Kalidomra/AdamNet-Drive-Emulator/Connection Diagram.jpg

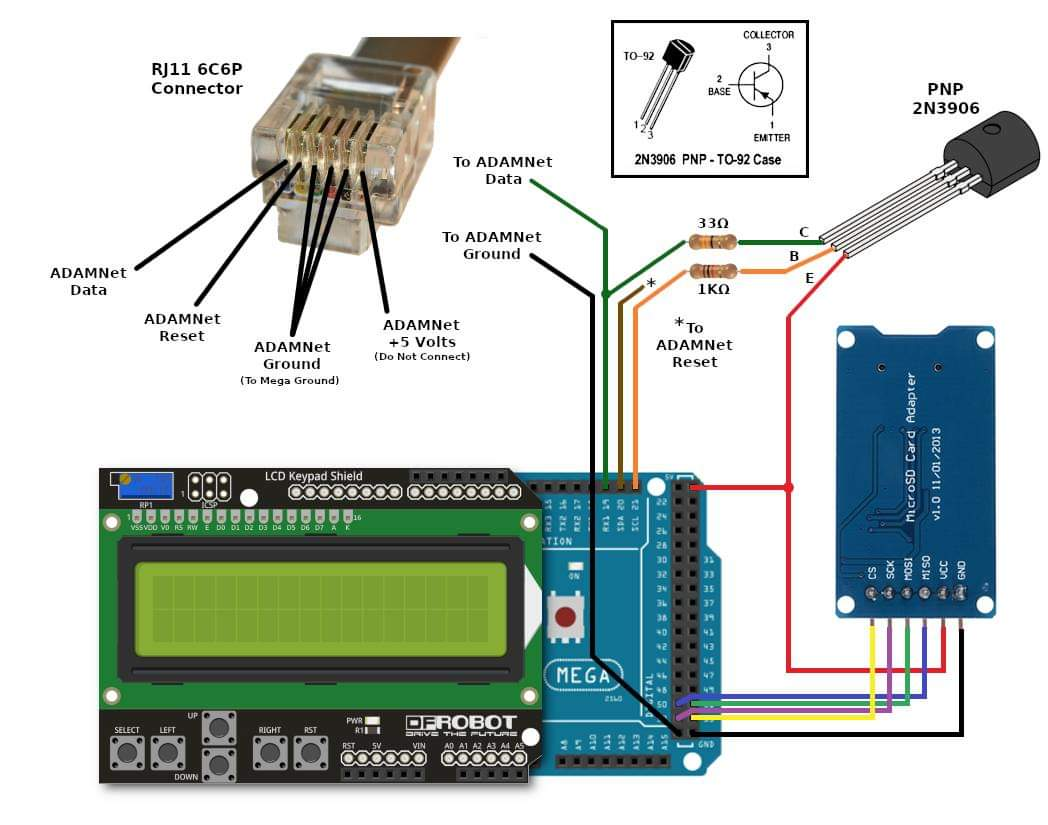
Connection Diagram.jpg
