Kalidomra/AdamNet-Drive-Emulator/(threads)

Thread 1 (2019-01-05):

Remember last file loaded apon reset or power on

JohnLundy, 2019-01-05:
The ability to remember last file loaded and have it default back to it after reset/power on to know where you left off the last time would be nice. Same functionality as the VDD. They save a text file on the SD card with the last loaded file.

Kalidomra, 2019-01-07:
Done.

Closed 2019-01-07.

Thread 2 (2019-01-05):

Make mount key dual purpose to mount and unmount files

JohnLundy, 2019-01-05:
The ability to use the mount key also as the unmount key will reduce keys required and simplify things. Same functionality as the VDD.

Kalidomra, 2019-01-05:
Can you clarify how this works? Right now if you select the mount key, it unmounts and then mounts the currently selected file on the bottom line.

You want to push the key twice to select a new file? Once to unmount and again to mount?

JohnLundy, 2019-01-05:
Correct, push twice to select a new file. This gives the option of having nothing mounted without using the left button. Everyone is familiar with this method from using the VDD. If this ever becomes a product or custom shield made, it will require less parts or possibly free up a button for future options.

Kalidomra, 2019-01-07:
Done.

Closed 2019-01-07.

Thread 3 (2019-01-07):

R/W activity LED

JohnLundy, 2019-01-07:
Would it be nice to have an activity LED flash when drives are reading or writing. Large loads keep you wondering if anything is happening.

Kalidomra, 2019-01-07:
Should be there. The default is the LED on the Mega, that happens to get covered up by the keypad. You can easily add an external LED with a resistor. Default is Pin 13.

JohnLundy, 2019-01-07:
Yep, I didn't notice it under the LCD/Button shield. I added an LED to the shield to make it viewable.

Closed 2019-01-07.

Thread 4 (2019-01-07):

Bug that allows same file to be mounted to multiple drives

JohnLundy, 2019-01-07:
Bug that allows same file to be mounted to multiple drives

Kalidomra, 2019-01-07:
This is not a bug. It is part of the current implementation. Because of the serial nature of AdamNet the same file can be accessed by multiple drives. Each time a block of 1k data to written, the file is opened and closed.

JohnLundy, 2019-01-07:
Gotcha, thanks for clearing that up. It's kind of hard to wrap your head around it at first.

Closed 2019-01-07.

Thread 6 (2019-01-07):

Read error during boot of ADAMCalc

JohnLundy, 2019-01-07:
Read error during boot of ADAMCalc. Was not an issue with first beta. Reloaded original beta and confirmed it does load fine on two separate ADAM consoles. Something changed?

JohnLundy, 2019-01-07:
I have now verified the same behavior with all three of my complete ADAM setups.

Kalidomra, 2019-01-08:
I have isolated the problem. It will take a re-write of the handling of the SD card file names. This is required to free up some additional memory. I was using a shared buffer for all 4 drives. This doesn't work with some programs as they expect repeat block reads to be immediate. So, I will need 4 x 1k buffers. One for each drive. The additional benefit will be an increase in the number of files and the length of the file names that can be used.

It will take a few days to re-write the SD card file name display section and setup the additional buffers.

Kalidomra, 2019-01-09:
My latest builds load Buck Rogers fine and plays through a few levels. Unfortunately, I'm not very good at it. I did not change the main read routine very much. Can you send me the image you tried, so I can check it.

JohnLundy, 2019-01-09:
Buck Rogers problem solved. Over the last couple days I switched from mirco SD to SD and used an older card with game images and apparently Buck Rogers was corrupt. Sorry for the confusion.

Kalidomra, 2019-01-11:
Fixed in v0.3

Closed 2019-01-11.

Thread 10 (2019-01-16):

Add the ability to auto mount a file to Drive 1.

Kalidomra, 2019-01-16:
This would automatically mount the designated file on an ADE reset. It would ignore any previously mounted files if the mount file was present. The file name will default to boot.dsk, but can be changed in the configuration section.

Kalidomra, 2019-02-08:
Complete in v0.4

Closed 2019-02-08.

Thread 11 (2019-01-16):

Add ability for individual input switches instead of analog line

JohnLundy, 2019-01-16:
Add the option in code to not use the analog switch input AD0 line and use dedicated digital I/O lines (selectable lines in code like for the activity indicator lines) for individual switches instead? This would come in handy for people who want to make custom projects and avoid dealing with possible resistor tolerance issues with using analog. Each line pulled low and detected with logical high with switch closure.

Kalidomra, 2019-01-16:
How many buttons are you thinking?

JohnLundy, 2019-01-16:
That's even better. The ADE is designed to work with the five switches on the LCD/Button shield. I'd say the ability for all five makes the most sense, even though I don't use the dedicated unmount switch in favor of the mount/unmount dual purpose switch.

Kalidomra, 2019-01-16:
Do you know how the ADE reacts if there is nothing attached to the AD0? Do I have to disable it in code or can I leave both analog and digital buttons functional regardless of whether they are installed or not.

JohnLundy, 2019-01-16:
I don't know the exact answer to that without real world testing. With that said, the AD0 line requires a 2k pull up for normal operation as part of the switch voltage divider even without any switch closures according to the schematic. I see no reason the system couldn't have both input methods, I just wouldn't leave the AD0 line floating without a 2k pull up to play it safe.

Kalidomra, 2019-01-16:
I will add the ability to disable the analog buttons in the configuration section.

Kalidomra, 2019-02-08:
Complete in v0.4

Closed 2019-02-08.

Thread 7 (2019-01-16):

Add support for Control Commands from the Adam.

Kalidomra, 2019-01-16:
Use the high byte of the high word on the block wanted to control the ADE from the Adam. Current list of proposed commands:
**F1 - Return Current SD Card Directory:** This would include an index number and the filename. There should be a limit on the filename length as 255 bytes would not be reasonable on the Adam. I propose to use 60. That would mean we could have 16 directory entries sent back per block read. So the Adam program would need to read multiple blocks to retrieve the whole directory. Read blocks F1000001, F1000002, F1000003, etc. It would not matter which device the read is issued to.
**F2 - Return Currently Mounted Disk:** If you read the block F2000000 on device 4, it would return the currently mounted file name in the block read.
**F3 - Mount/Unmount Disk:** This would mount the disk by index number. Using the lower word as the index to mount. So if you read F3000112 on device 4, the ADE would mount file 274 (112 hex) on device 4.  Sending a 0 index number would unmount.
**F4 - Write to LCD:** This is a write command. Load the block with 32 bytes of ascii text and send this as a write. The ADE will then display the text on the LCD. It would not matter which device the write is issued to.
**FA - Format:** This would format the device. This would be an alternative to the existing FACE. This is required so we can disable the original FACE support and use that block without a risk of format.

Kalidomra, 2019-02-08:
Complete in v0.4. See the included sample ADE basic disks to see how it works.

Closed 2019-02-08.

Thread 12 (2019-01-17):

Add the ability to reset the Adam on ADE reset

Kalidomra, 2019-01-17:
This would reset the Adam when the ADE finishes all of the setup.  It would require that the reset line from the AdamNet connect be attached to a pin on the Arduino. The benefit to this would be that if a boot disk is defined, one button press would re-mount the boot disk and reset the Adam. A variable in the configuration section should allow this to be disabled.

Kalidomra, 2019-01-21:
This does not appear to be possible. The reset line on the Adamnet is an output not an input . So it will signal a reset of the Adam, but we can not initiate a reset.

Closed 2019-01-21.

Thread 13 (2019-02-13):

Add Device Selection Menu

Kalidomra, 2019-02-13:
If the Drive Select button is held on power up, jump to a drive selection menu. This would allow the user to select the drives to be turned on or off.

Kalidomra, 2019-02-28:
Complete in v0.5.

Closed 2019-02-28.

Thread 14 (2019-03-17):

Analog buttons still enabled during boot when using digital buttons

JohnLundy, 2019-03-17:
Analog buttons still enabled during boot when using digital buttons and intermittently causing unit to falsely boot to config mode on power up. This is an issue only when designs are based around using digital buttons.  Need to add check if ‘EnableAnalogButtons = false’ variable is set to ignore analog buttons during boot when checking if the select key is held down to enable config mode on boot up.

Kalidomra, 2019-03-20:
Fixed in beta v0.6

Closed 2019-03-20.

Thread 15 (2019-03-17):

Button scan time changes for digital buttons vs. analog buttons

JohnLundy, 2019-03-17:
Add the ability to change button scan times based on both digital and analog button settings. Maybe have this ability tied to the ‘EnableAnalogButtons = false/true’ variable adjustment.

Analog buttons seem to work best with a setting of ButtonDelay >= 150 and digital buttons seem to work best with a setting of ButtonDelay >= 120.

Kalidomra, 2019-03-20:
Added to beta v0.6

Closed 2019-03-20.

Thread 17 (2019-04-16):

Send the ADE status on a 0xDEADBEEF read

Kalidomra, 2019-04-16:
When switching to the enhanced mode on a read to block 0XDEADBEEF, send the status of the ADE. This could include the firmware version also. This would enable the Adam to detect when an ADE is connected and not another device.

Kalidomra, 2019-05-26:
Added to v0.70.

Closed 2019-05-26.

Thread 18 (2019-04-16):

Boot disk image is case sensitive

JohnLundy, 2019-04-16:
For the boot image to automatically boot it has to be all lowercase in order to work, including the extension. Add the ability to make it not case sensitive to make it less confusing.

Kalidomra, 2019-04-16:
The boot disk filename is definable in the variables at the top of the main Arduino file. In order to make this more user friendly, the defined filename and the filename read from the SD card will need to be converted to lower case and then compared. This should be simple to implement.

Kalidomra, 2019-05-26:
Fixed in v0.70.

Closed 2019-05-26.

Thread 20 (2019-05-14):

Adam Software Initiated Reset

Kalidomra, 2019-05-14:
If the Adam initiates a "soft" reset and there is a boot.dsk on the SD card, the boot.dsk it mounted and causes issues. 3 know titles that this is an issue:
 - Family Feud
 - Jeopardy
 - Bible Jeopardy

These disks start fine and half way through the loading process initial a reset on the Adam.

Kalidomra, 2019-05-26:
Fixed in v0.70.

Closed 2019-05-26.

Thread 21 (2019-05-28):

Setting ‘const unsigned int namelength =’ less than 71 will lock up the ADE.

JohnLundy, 2019-05-28:
Setting ‘const unsigned int namelength =’ to less than 41 locks the ADE up on boot. Setting it between 41 and 71 will lock the ADE when scrolling through files. Higher the setting will require more scrolling to lock up the ADE. This appears to be a carryover from v0.6 as well.

Kalidomra, 2019-09-23:
Fixed in v0.80

Closed 2019-09-23.

Thread 22 (2019-07-30):

When using an IDEboot PROM the boot timing is altered and changes the TimeSinceReset value causing issues with ADE compatibility

JohnLundy, 2019-07-30:
When using an IDEboot PROM in expansion slot 2 the boot timing is altered and changes the TimeSinceReset value causing issues with ADE compatibility. It has been found that it is required to add an additional lower range for compatibility. Tests have show a range of 15 – 23 is required.

 if (((TimeSinceReset <= 175) && (TimeSinceReset >= 153)) || ((TimeSinceReset <= 23) && (TimeSinceReset >= 15))){ // Lower range is needed for IDEboot PROM compatibility

Kalidomra, 2019-09-23:
Fixed in v0.80

Closed 2019-09-23.

Thread 23 (2019-07-30):

SD Command issues mounting D3 and also throwing errors in the terminal with v0.73

JohnLundy, 2019-07-30:
SD Command issues mounting D3 and also throwing errors in the terminal with v0.73. It has been found that the buffer needs to be zeroed out first to correct this issue.

Replace:
LoadedBlock[devicenumber-4] = 0xFFFFFFFF;

With:
BlockBuffer[devicenumber-4][0] = 0xB0 + devicenumber; // Need to zero out the buffer
BlockBuffer[devicenumber-4][1] = 0x04;
BlockBuffer[devicenumber-4][2] = 0x00;

Kalidomra, 2019-09-23:
Fixed in v0.80

Closed 2019-09-23.

Thread 24 (2019-12-09):

Read Errors on some Clone Arduino Megas

Kalidomra, 2019-12-09:
Some cheaper Arduino clones use poor quality resonators. This can cause read errors on AdamNet, due to the bit bang timing being off. The Motorola 6801 that is used in the Adam is able to tolerate up to 3.5% difference in serial communication speed.

plasticuser, 2020-02-11:
I should be ok with a +/- 2--ppm oscillator on my custom Pro board?

Kalidomra, 2020-02-11:
Generally an oscillator is the preferred method. They are very accurate. 2 ppm is equal to 15999968 hz - 16000032 hz. The issue is with the low quality resonators that some mega clones use. These appear to be outside of the normal tolerances of a name brand resonator. I have measured some at 15850700 hz.

plasticuser, 2020-02-11:
2--ppm should be 200ppm, sorry.

I'm developing a single board ADE interface that could support two SD cards, ADAMNet pass-thru, and if you'll support it a more satisfying OLED or mini-TFT display. I'm also going to make it VERY small. My main objective is to lower the price so it is more accessible.

I would love to pick your brains about some smaller technical matters, eg: power, and the notion of forking your ADAMNet stack for a video adapter I've designed. dave@nonstickglue.com

Kalidomra, 2020-02-11:
200ppm is more than accurate enough. I have modified the timings to tolerate the worst mega clone that I have. I am currently testing this. It will be released soon.

If you want to add a feature to the ADE, submit an issue as an improvement. Or you can create your own fork.

plasticuser, 2020-02-11:
I'd prefer to keep everything unified - forks muddy the waters too much. People need a consistent experience. I'll post a couple of thoughts...

Kalidomra, 2020-02-23:
Fixed in v0.82

Closed 2020-02-23.

Thread 25 (2020-02-04):

Some users are experiencing bounce issues with buttons

JohnLundy, 2020-02-04:
Some users are experiencing bounce issues with buttons causing issues. This is especially noticeable when scrolling through the image file list and is causing images to be skipped and not displayed.

Kalidomra, 2020-02-23:
Fixed in v0.82

Closed 2020-02-23.

Thread 26 (2020-02-11):

Request OLED or TFT display support...

plasticuser, 2020-02-11:
It would be nice to move beyond 1602 displays. Besides not being very clear, they crop off a lot of the file names. A modest OLED display based around a common chipset would be easy to support.

The killer feature is being able to have three lines of clear, high resolution text, so you can see the selected file, the file above and the file below as you scroll through the list. I think this would greatly improve usability.

Kalidomra, 2020-02-11:
Please specify the OLED you are thinking of using.

plasticuser, 2020-02-11:
I was thinking an I2C 0.96" 128x64 unit using the SSD1306 driver. This doesn't interfere with your current use of SPI. They are available in white, blue, or yellow top 1/4 and blue bottom 3/4, There are many brands to choose from. SSD1306 also supports a range of color TFT displays, and other OLED displays of 128x32 size, though those are a bit small for this.

plasticuser, 2020-03-01:
I have developed this idea further, and this feature has become quite essential to my plans. I intend to add a remote control with a custom matrix keypad - mostly because having a custom remote matrix made and using an OLED display is a cheaper and more elegant solution than buying expensive 1602 displays on button entry PCBs.

Anything which only uses an IR link will work natively with your code without changes, introduce mechanical reliability, and increase mounting options to include internal mounting with only the SD slot and a sensor showing.

It will allow me to lower the retail cost of the ADE by another $10-15, while improving mounting options and usability in almost every way. It will also allow people to buy standard arduino accessory parts that are still cheaper than the 1602 input shields. It doesn't limit accessibility at all.

Kalidomra, 2020-03-02:
What about the ADE in it's current form is not "mechanically reliable"?
Why would having the ADE functional with a remote control be desired? Will the keyboard and joysticks also be remote? What about the need to reset the Adam?

plasticuser, 2020-03-03:
Stacks of boards are for prototyping. It's nice that they're available. But to compensate for the fact they're multiple boards held together with jumper wire and push fit contacts, people are charging almost $100 for a box to put it in. One of your stated goals was to make it affordable and accessible to everyone. So, I was simple "productizing" your ADE board. Every request has been an effort to improve the product this code runs on. I do have the ability to produce a single board that can do everything this does for about the same cost as buying all the parts separately - as many have done.

I'm not knocking their experience - I am only reacting to my own observations of my and others' use.

The remote functionality is to allow the ADE to be embedded behind a grille or in a slot. It would allow more room for a larger OLED from the same driver family. The remote would have a custom made front laminate, and would match the Adam perfectly. It would do debounce for you in the remote.

I can't see any benefit in the keyboard or joysticks being remote. The keyboard's an ADAMnet device, and just plugs in right there.

At the end of the day, the LCD/input shield is the weakest and most mechanically vulnerable part of the ADE. It forces a certain chunkiness on the design, and makes it less convenient to embed. It's also the most expensive component. OLED displays are 1/4-1/5 the price. Keyes remotes are 1/4 the price. It just gives people more options to build different implementations. With the SD shield firmly mounted in the 'duino I pressed buttons and the vibration was causing intermittent connection to the SD card, which was problematic.

I'm looking at forking the code, _not to duplicate your work/ADE_ but to use the ADAMnet stack you've developed to allow other options like ADAMnet<>PS/2 adapter as keyboards are in short supply, and an ADAMnet floppy controller, because why not? :D

Closed 2023-03-09.

Thread 27 (2020-02-11):

Keyboard image search

plasticuser, 2020-02-11:
Would it be possible (since the ADAMNet allows every device to snoop every other) that is the keyboard typed an unlikely Hayes-like command (eg: +++ after a three second gap) further typing could be read by the ADE to filter the disk image list down to one or very few images?

Kalidomra, 2020-02-11:
Intercepting the keyboard commands on ADAMNet is possible. However, the Adam will still register the keystrokes.
The way the ADE displays the filename on the display is by looking it up on the SD card. It does not keep a list of the current directory filenames, only index numbers. There is not enough memory left on the mega to have a large text array. In order to complete this type of alphabetical sort, it would need to look up each file in the current directory on the SD card. This is too slow and not practical.

plasticuser, 2020-02-11:
The internal 8K SRAM is quite limiting. What if you had an extra 32K? ;)

Kalidomra, 2020-02-11:
I do not plan on adding additional memory, The goal of the ADE was to have a hobby level device that anyone can build. Limiting it to a specialized hardware with surface mount components is not what I was trying to achieve.

plasticuser, 2020-02-11:
Well, it's just a different Arduino board, but yeah, I understand.

Closed 2020-02-12.

Thread 28 (2020-02-12):

Add support for 2nd SD slot

plasticuser, 2020-02-12:
It might be nice (and easy) to add support for a second SD card. This might be implemented with a separate SPI port, or shared SPI port and second select line.

It would make copying SD cards much easier without a PC. It would just require a second SD shield.

plasticuser, 2020-02-12:
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
This is what I had in mind. Dual SD cards with screen above them in front of case, plus a backplane of four further expansion slots for future expansion. RJ12 pass-thru. Adam serial would be internally buffered. Minimal ATmega2560 system plus update serial port made directly on board.

Kalidomra, 2020-02-13:
What is the use case for this? I am unable to see why we would need to copy SD cards on the ADE. A PC or a Mac is better suited for this task.

plasticuser, 2020-02-13:
One use case is that sometimes a user might want two disk images open, with access to both simultaneously without button pressing. One might contain program, the other data. It makes more sense to have two devices supported by one ATmega than having two separate ADE boards, one configured to each disk position. On John Lundy's product there is an option to select drive 0 or 1.

It is true that doing back-ups is easier on a PC, but it would be more convenient for some to do it on the Adam.

I would ideally like to add a little on-board DIP switch that allows the user to select 0, 1, 2, for the left slot and the right slot be left slot +1. If you decide not to provide this functionality in firmware, I'd have to use two ATmegas and increase the cost on the dual slot boards by about $20. I'd prefer to charge every user $20 less and have it implemented in software.

The main programming task in this is selecting for the display and input to be connected clearly to slot 1 or slot 2. This is a part of why I made the feature request to support OLED displays. More characters, more lines, and higher readability.

Kalidomra, 2020-02-13:
It is not possible to have 2 disk images associated with an Adam drive simultaneously. The ADE (and all variants) already support 4 ADAM drives, with one SD card.  I'm confused by what you are talking about "drive 0 and 1" The Adam uses 4 device numbers for disk drives (Device 4, 5, 6 and 7). These are called drives 1-4 on the ADE.

plasticuser, 2020-02-13:
I am maybe using improper terminology.

Devices 4 and 5. (or 5/6, or 6/7)

The ATmega can listen for requests and direct a request for device 4 to slot 1's SD, and for device 5 to slot 2's SD. Two drives could be mounted simultaneously, implemented through a single ATmega.

In a couple of months, when China gets back on its feet, I'll be releasing a LARGE memory expansion for the Adam - more than anyone might ever want to use. 2MB will be standard, with 4/8/12MB shields offering a total of 14MB max. I'll then be releasing a 2MB video card once drivers are a little more developed, rounding out the 16MB max address range through paging. This will open up a lot of new options for the Adam for a certain subset of users. Being able to quickly load and save more than 258K is an important feature, and one that realistically only ADE supports in any meaningful sense.

PS: If microcontroller SRAM is an issue, I have retargeted the code to the AT91SAM3X8E (Due) device. Just because it compiles without error doesn't mean it works, though, but I could as easily design a board around that device if it suits extending functionality. It's a much more capable device. 96K SRAM, 84MHz.

PPS: it is a goal to use your ADAMnet stack to implement parallel, floppy (WD1772), PS/2 and other ports, to go on the backplane. While lowering prices/costs to make this all accessible to a lot more people.

plasticuser, 2020-02-13:
Re-rephrase. 4 logical drives, two physical SD cards, Be able to map either SD to any available logical drive(s).

There, that's more concise.

Sorry :)

Kalidomra, 2020-02-13:
You do not need 2 SD cards to do this. This will add complexity that is not required.

plasticuser, 2020-02-13:
Just to be certain, ADE as it stands supports mounting four logical devices at once to four logical drives off one SD card?

Kalidomra, 2020-02-13:
Yup. You can even mount the same image to all 4 drives. It will only open the disk image file when it needs to read or write a block and then it will close it.
Do you have an ADE?

plasticuser, 2020-02-13:
Yes. Self-built. Only been using it a few days though, to have enough awareness to make it into a single board device. I'm just trying to make it available to Joe Blow at a lower price point than ANN, in a highly integrated package.

Your point on multiple logical devices open weakens much of my request, and leaves coding only to be able to duplicate SDs in system. I see your POV much better now. Thank you.

I will close the request.

Closed 2020-02-13.

Thread 29 (2020-03-01):

Add support for rotary encoder?

plasticuser, 2020-03-01:
Would it be possible to add support for a rotary encoder? This would allow quick and intuitive scrolling through the mountable images list far more quickly than pressing up and down buttons - especially when there are several tens or 100s of images. People intuitively know where most of their images are, and can quickly scroll to them - far faster than pressing a button 10s or 100s of times.

There are standard Arduino rotary encoders that would cheaply and elegantly fit this project.

I am interested in using the KY-040 or similar. Would you be interested in supporting this?

Kalidomra, 2020-03-02:
I like the idea of having this as an option. However, I have no plans to add it.  The existing buttons work fine and you don't need to press them 100's of times. You can hold them down.

plasticuser, 2020-03-03:
This was just an idea that I thought would improve the user interface a little. Rotary encoders are a nice way to scroll through long lists. It was merely a suggestion to increase people's choices about how to interact with it. It goes with the other request of offering support for a different display type like TFT or OLED which has a much quicker response time, as 1602 displays have very variable update speeds depending on temperature and they blur horribly with fast changing data if they're cold.

All of these ideas have a common theme - Adam owners are getting older and so are the computers. I shouldn't have to pick up a box to mount an image, and I shouldn't have to reach over and press on a computer. Things like better displays, and remote controls, are all about increasing mounting options and how to interact with the ADE. They would need very small additions to the input routine adding just a few bytes and maybe a single library.

Given the SRAM limit is your main restraint, it might be fun to target a different device that costs the same, like the SAM38Xe (Due)?

Closed 2023-03-09.

Thread 30 (2020-03-06):

Add support for sketch updating by file on SD card?

plasticuser, 2020-03-06:
It would be nice if users with an existing install of ADE could copy an update onto their SD card, and on start-up the ATmega could check the SD card for an update and import it then reset if one is present. This would allow a lot of users not comfortable with using the Arduino IDE to more easily keep their systems current.

This is also very easy to implement.

Kalidomra, 2020-03-09:
In my research, this requires a different boot loader. Do you have a method to do this without modifying the boot loader?

plasticuser, 2020-03-10:
Ah, a wrinkle!

I'm sorry, boot loaders and that level of usage isn't my area of expertise, so I honestly don't know. It was just a thought that might make people's upgrades a bit easier. If it's too complex or increases the footprint too much, it becomes an unrealistic option.

I'll keep googling around and see if there is an alternate way to do it without changing the bootloader.

(Sorry, I'm 90% a hardware guy)

Closed 2020-03-10.

Thread 31 (2020-05-16):

Capacitive touch

plasticuser, 2020-05-16:
It looks like at some point you shifted from capacitive touch to tactile buttons. I was just wondering if this was for a technical reason, or because of the convenience of the tactile buttons included on many LCD shields?

I'm considering using capacitive touch as a way of lowering costs and reducing moving parts, if the OLED option materializes - and maybe even if it doesn't.

This also lets me create a generic LCD shield with capacitive touch that would look really nice for use on standard ATmega boards too.

(I've been waiting for boards for *ages* but some prototype boards just came in so I am back on the case!)

Kalidomra, 2020-05-21:
The ADE was created with the 1602 LCD Keypad Shield. So, no capacitive touch buttons. Later I added the individual digital buttons as an option.

Closed 2020-05-21.

Thread 32 (2020-12-31):

Must use v1 of SdFat

MHeironimus, 2020-12-31:
Thank you for sharing this project. I was able to replicate it and it worked great.

One thing you might want to update on the README is that you must use v1 of the SD Card Library (https://github.com/greiman/SdFat/tree/1.1.4), not the latest version. If you try using the latest version (which was 2.0.4 when I wrote this), you will get the following compiler error:

```
C:\Users\heiro\OneDrive\Arduino\AdamNet_Drive_Emulator\DeviceSetup.ino: In function 'void DeviceSetup()':
DeviceSetup:105:50: error: no matching function for call to 'SdFat32::chdir(const char*, bool)'
       dirtest = sd.chdir(BootDiskDir.c_str(),true);
                                                  ^
In file included from C:\Users\heiro\Documents\Arduino\libraries\SdFat-2.0.4\src/FatLib/FatLib.h:27:0,
                 from C:\Users\heiro\Documents\Arduino\libraries\SdFat-2.0.4\src/SdFat.h:34,
                 from C:\Users\heiro\OneDrive\Arduino\AdamNet_Drive_Emulator\AdamNet_Drive_Emulator.ino:4:
C:\Users\heiro\Documents\Arduino\libraries\SdFat-2.0.4\src/FatLib/FatVolume.h:66:8: note: candidate: bool FatVolume::chdir()
   bool chdir() {
        ^~~~~
C:\Users\heiro\Documents\Arduino\libraries\SdFat-2.0.4\src/FatLib/FatVolume.h:66:8: note:   candidate expects 0 arguments, 2 provided
C:\Users\heiro\Documents\Arduino\libraries\SdFat-2.0.4\src/FatLib/FatVolume.h:75:8: note: candidate: bool FatVolume::chdir(const char*)
   bool chdir(const char *path);
        ^~~~~
C:\Users\heiro\Documents\Arduino\libraries\SdFat-2.0.4\src/FatLib/FatVolume.h:75:8: note:   candidate expects 1 argument, 2 provided
C:\Users\heiro\Documents\Arduino\libraries\SdFat-2.0.4\src/FatLib/FatVolume.h:250:8: note: candidate: bool FatVolume::chdir(const String&)
   bool chdir(const String& path) {
        ^~~~~
C:\Users\heiro\Documents\Arduino\libraries\SdFat-2.0.4\src/FatLib/FatVolume.h:250:8: note:   candidate expects 1 argument, 2 provided
C:\Users\heiro\OneDrive\Arduino\AdamNet_Drive_Emulator\DeviceSetup.ino: In function 'void DeviceSetupCommand(byte)':
DeviceSetup:159:52: error: no matching function for call to 'SdFat32::chdir(const char*, bool)'
   boolean dirtest = sd.chdir(eepromdir.c_str(),true);
                                                    ^
...
```

See https://github.com/greiman/SdFat/issues/222 for more details.

Thanks again for sharing this awesome project!

Kalidomra, 2021-01-01:
Thanks for the heads up. I see there are a number of changes to SDFat 2.0. I have added a note to the readme to only use SDFat 1.1.4.

Closed 2021-01-01.

Thread 33 (2021-01-23):

Change the current behavior of the SWAP button held during boot.

JohnLundy, 2021-01-23:
Now that ADE Commander has full control of enabling / disabling any combination of drives (D1-D4), it would probably be best to change the current behavior of the SWAP button when held down during boot. It currently will disable D2 for use when a physical drive is used and holding again will enable all drives to a known usable state in case all drives are disable on ADE variants without a display.

It would now probably be best to have all drives disabled now to quickly and easily simulate the ADE not on ADAMnet and holding again will enable all drives. Any other combination can be done through ADE Commander.

The following setup() changes have been tested

 if (InitialKeypress == 6){                 // Swap Button Held - All devices disabled (simulates ADE being removed from ADAMnet)
                                                      // If Device 5 is already disabled, all devices enabled
    if (EEPROM.read(5) == 1){
      Serial.println(F("Disabling all Devices"));
      EEPROM.write(4,0);                   // Disable Device 4
      EEPROM.write(5,0);                   // Disable Device 5
      EEPROM.write(6,0);                   // Disable Device 6
      EEPROM.write(7,0);                   // Disable Device 7
    }
    else if (EEPROM.read(5) == 0){   // Enable all Devices for normal operation and correct any config errors that could make devices lost for good.
      Serial.println(F("Enabling all Devices"));
      EEPROM.write(4,1);                   // Enable Device 4
      EEPROM.write(5,1);                   // Enable Device 5
      EEPROM.write(6,1);                   // Enable Device 6
      EEPROM.write(7,1);                   // Enable Device 7
    }
  }

Thread 34 (2021-01-24):

Long press of the SWAP button to turn off/on auto mounting of the boot disk

JohnLundy, 2021-01-24:
It would be nice to have the option of turn off/on auto mounting of the boot disk for ADE variants without a DRIVE SELECT button but do have a SWAP button.

Maybe even have the ADE Lite code activity LED high/low configuration change so the LED state is off when auto mounting of the boot disk is disabled with no drive activity. When auto mounting of the boot disk is enabled, have the LED state on with no drive activity to indicate it is active.

Thread 36 (2021-06-08):

Issue with compiling

8BitMilli, 2021-06-08:
I am trying to compile the source code and I get the following errors. I installed the SdFAT library. Is there another library that needs to be installed? I am using Arduino 1.8.13. I know I can just download the compiled binaries but I wish to compile it myself.

Arduino: 1.8.13 (Linux), Board: "Arduino Mega or Mega 2560, ATmega2560 (Mega 2560)"

/home/william/AIP/ADE/AdamNet-Drive-Emulator-master - v.90/AdamNet_Drive_Emulator/DeviceSetup.ino: In function 'void DeviceSetup()':
DeviceSetup:105:50: error: no matching function for call to 'SdFat32::chdir(const char*, bool)'
       dirtest = sd.chdir(BootDiskDir.c_str(),true);
                                                  ^
In file included from /home/william/snap/arduino/current/Arduino/libraries/SdFat/src/FatLib/FatLib.h:27:0,
                 from /home/william/snap/arduino/current/Arduino/libraries/SdFat/src/SdFat.h:34,
                 from /home/william/AIP/ADE/AdamNet-Drive-Emulator-master - v.90/AdamNet_Drive_Emulator/AdamNet_Drive_Emulator.ino:4:
/home/william/snap/arduino/current/Arduino/libraries/SdFat/src/FatLib/FatVolume.h:66:8: note: candidate: bool FatVolume::chdir()
   bool chdir() {
        ^~~~~
/home/william/snap/arduino/current/Arduino/libraries/SdFat/src/FatLib/FatVolume.h:66:8: note:   candidate expects 0 arguments, 2 provided
/home/william/snap/arduino/current/Arduino/libraries/SdFat/src/FatLib/FatVolume.h:75:8: note: candidate: bool FatVolume::chdir(const char*)
   bool chdir(const char *path);
        ^~~~~
/home/william/snap/arduino/current/Arduino/libraries/SdFat/src/FatLib/FatVolume.h:75:8: note:   candidate expects 1 argument, 2 provided
/home/william/snap/arduino/current/Arduino/libraries/SdFat/src/FatLib/FatVolume.h:250:8: note: candidate: bool FatVolume::chdir(const String&)
   bool chdir(const String& path) {
        ^~~~~
/home/william/snap/arduino/current/Arduino/libraries/SdFat/src/FatLib/FatVolume.h:250:8: note:   candidate expects 1 argument, 2 provided
/home/william/AIP/ADE/AdamNet-Drive-Emulator-master - v.90/AdamNet_Drive_Emulator/DeviceSetup.ino: In function 'void DeviceSetupCommand(byte)':
DeviceSetup:159:52: error: no matching function for call to 'SdFat32::chdir(const char*, bool)'
   boolean dirtest = sd.chdir(eepromdir.c_str(),true);
                                                    ^
In file included from /home/william/snap/arduino/current/Arduino/libraries/SdFat/src/FatLib/FatLib.h:27:0,
                 from /home/william/snap/arduino/current/Arduino/libraries/SdFat/src/SdFat.h:34,
                 from /home/william/AIP/ADE/AdamNet-Drive-Emulator-master - v.90/AdamNet_Drive_Emulator/AdamNet_Drive_Emulator.ino:4:
/home/william/snap/arduino/current/Arduino/libraries/SdFat/src/FatLib/FatVolume.h:66:8: note: candidate: bool FatVolume::chdir()
   bool chdir() {
        ^~~~~
/home/william/snap/arduino/current/Arduino/libraries/SdFat/src/FatLib/FatVolume.h:66:8: note:   candidate expects 0 arguments, 2 provided
/home/william/snap/arduino/current/Arduino/libraries/SdFat/src/FatLib/FatVolume.h:75:8: note: candidate: bool FatVolume::chdir(const char*)
   bool chdir(const char *path);
        ^~~~~
/home/william/snap/arduino/current/Arduino/libraries/SdFat/src/FatLib/FatVolume.h:75:8: note:   candidate expects 1 argument, 2 provided
/home/william/snap/arduino/current/Arduino/libraries/SdFat/src/FatLib/FatVolume.h:250:8: note: candidate: bool FatVolume::chdir(const String&)
   bool chdir(const String& path) {
        ^~~~~
/home/william/snap/arduino/current/Arduino/libraries/SdFat/src/FatLib/FatVolume.h:250:8: note:   candidate expects 1 argument, 2 provided
/home/william/AIP/ADE/AdamNet-Drive-Emulator-master - v.90/AdamNet_Drive_Emulator/FACECommand.ino: In function 'void FACECommand(byte)':
FACECommand:13:34: error: no matching function for call to 'SdFat32::chdir(const char*, bool)'
     sd.chdir(filedir.c_str(),true);
                                  ^
In file included from /home/william/snap/arduino/current/Arduino/libraries/SdFat/src/FatLib/FatLib.h:27:0,
                 from /home/william/snap/arduino/current/Arduino/libraries/SdFat/src/SdFat.h:34,
                 from /home/william/AIP/ADE/AdamNet-Drive-Emulator-master - v.90/AdamNet_Drive_Emulator/AdamNet_Drive_Emulator.ino:4:
/home/william/snap/arduino/current/Arduino/libraries/SdFat/src/FatLib/FatVolume.h:66:8: note: candidate: bool FatVolume::chdir()
   bool chdir() {
        ^~~~~
/home/william/snap/arduino/current/Arduino/libraries/SdFat/src/FatLib/FatVolume.h:66:8: note:   candidate expects 0 arguments, 2 provided
/home/william/snap/arduino/current/Arduino/libraries/SdFat/src/FatLib/FatVolume.h:75:8: note: candidate: bool FatVolume::chdir(const char*)
   bool chdir(const char *path);
        ^~~~~
/home/william/snap/arduino/current/Arduino/libraries/SdFat/src/FatLib/FatVolume.h:75:8: note:   candidate expects 1 argument, 2 provided
/home/william/snap/arduino/current/Arduino/libraries/SdFat/src/FatLib/FatVolume.h:250:8: note: candidate: bool FatVolume::chdir(const String&)
   bool chdir(const String& path) {
        ^~~~~
/home/william/snap/arduino/current/Arduino/libraries/SdFat/src/FatLib/FatVolume.h:250:8: note:   candidate expects 1 argument, 2 provided
FACECommand:14:22: error: 'FatFile* FatVolume::vwd()' is private within this context
     file.open(sd.vwd(),fileindexnumber, O_READ | O_WRITE);
                      ^
In file included from /home/william/snap/arduino/current/Arduino/libraries/SdFat/src/FatLib/FatLib.h:27:0,
                 from /home/william/snap/arduino/current/Arduino/libraries/SdFat/src/SdFat.h:34,
                 from /home/william/AIP/ADE/AdamNet-Drive-Emulator-master - v.90/AdamNet_Drive_Emulator/AdamNet_Drive_Emulator.ino:4:
/home/william/snap/arduino/current/Arduino/libraries/SdFat/src/FatLib/FatVolume.h:336:12: note: declared private here
   FatFile* vwd() {return &m_vwd;}
            ^~~
/home/william/AIP/ADE/AdamNet-Drive-Emulator-master - v.90/AdamNet_Drive_Emulator/GetFileName.ino: In function 'String GetFileName(unsigned int, byte)':
GetFileName:16:36: error: 'FatFile* FatVolume::vwd()' is private within this context
   byte opentest = file.open(sd.vwd(),FilesIndex[IncomingFileIndex], O_READ);
                                    ^
In file included from /home/william/snap/arduino/current/Arduino/libraries/SdFat/src/FatLib/FatLib.h:27:0,
                 from /home/william/snap/arduino/current/Arduino/libraries/SdFat/src/SdFat.h:34,
                 from /home/william/AIP/ADE/AdamNet-Drive-Emulator-master - v.90/AdamNet_Drive_Emulator/AdamNet_Drive_Emulator.ino:4:
/home/william/snap/arduino/current/Arduino/libraries/SdFat/src/FatLib/FatVolume.h:336:12: note: declared private here
   FatFile* vwd() {return &m_vwd;}
            ^~~
/home/william/AIP/ADE/AdamNet-Drive-Emulator-master - v.90/AdamNet_Drive_Emulator/GetFileNumber.ino: In function 'unsigned int GetFileNumber(unsigned int, String, String)':
GetFileNumber:8:36: error: no matching function for call to 'SdFat32::chdir(const char*, bool)'
   sd.chdir(IncomingDir.c_str(),true);                              // Change to the directory
                                    ^
In file included from /home/william/snap/arduino/current/Arduino/libraries/SdFat/src/FatLib/FatLib.h:27:0,
                 from /home/william/snap/arduino/current/Arduino/libraries/SdFat/src/SdFat.h:34,
                 from /home/william/AIP/ADE/AdamNet-Drive-Emulator-master - v.90/AdamNet_Drive_Emulator/AdamNet_Drive_Emulator.ino:4:
/home/william/snap/arduino/current/Arduino/libraries/SdFat/src/FatLib/FatVolume.h:66:8: note: candidate: bool FatVolume::chdir()
   bool chdir() {
        ^~~~~
/home/william/snap/arduino/current/Arduino/libraries/SdFat/src/FatLib/FatVolume.h:66:8: note:   candidate expects 0 arguments, 2 provided
/home/william/snap/arduino/current/Arduino/libraries/SdFat/src/FatLib/FatVolume.h:75:8: note: candidate: bool FatVolume::chdir(const char*)
   bool chdir(const char *path);
        ^~~~~
/home/william/snap/arduino/current/Arduino/libraries/SdFat/src/FatLib/FatVolume.h:75:8: note:   candidate expects 1 argument, 2 provided
/home/william/snap/arduino/current/Arduino/libraries/SdFat/src/FatLib/FatVolume.h:250:8: note: candidate: bool FatVolume::chdir(const String&)
   bool chdir(const String& path) {
        ^~~~~
/home/william/snap/arduino/current/Arduino/libraries/SdFat/src/FatLib/FatVolume.h:250:8: note:   candidate expects 1 argument, 2 provided
GetFileNumber:9:31: error: 'FatFile* FatVolume::vwd()' is private within this context
   while (file.openNext(sd.vwd(), O_READ)) {                        // Loop through the directory
                               ^
In file included from /home/william/snap/arduino/current/Arduino/libraries/SdFat/src/FatLib/FatLib.h:27:0,
                 from /home/william/snap/arduino/current/Arduino/libraries/SdFat/src/SdFat.h:34,
                 from /home/william/AIP/ADE/AdamNet-Drive-Emulator-master - v.90/AdamNet_Drive_Emulator/AdamNet_Drive_Emulator.ino:4:
/home/william/snap/arduino/current/Arduino/libraries/SdFat/src/FatLib/FatVolume.h:336:12: note: declared private here
   FatFile* vwd() {return &m_vwd;}
            ^~~
/home/william/AIP/ADE/AdamNet-Drive-Emulator-master - v.90/AdamNet_Drive_Emulator/LCDRefresh.ino: In function 'void LCDRefresh()':
LCDRefresh:12:45: error: no matching function for call to 'SdFat32::chdir(const char*, bool)'
       sd.chdir(CurrentDirectory.c_str(),true);
                                             ^
In file included from /home/william/snap/arduino/current/Arduino/libraries/SdFat/src/FatLib/FatLib.h:27:0,
                 from /home/william/snap/arduino/current/Arduino/libraries/SdFat/src/SdFat.h:34,
                 from /home/william/AIP/ADE/AdamNet-Drive-Emulator-master - v.90/AdamNet_Drive_Emulator/AdamNet_Drive_Emulator.ino:4:
/home/william/snap/arduino/current/Arduino/libraries/SdFat/src/FatLib/FatVolume.h:66:8: note: candidate: bool FatVolume::chdir()
   bool chdir() {
        ^~~~~
/home/william/snap/arduino/current/Arduino/libraries/SdFat/src/FatLib/FatVolume.h:66:8: note:   candidate expects 0 arguments, 2 provided
/home/william/snap/arduino/current/Arduino/libraries/SdFat/src/FatLib/FatVolume.h:75:8: note: candidate: bool FatVolume::chdir(const char*)
   bool chdir(const char *path);
        ^~~~~
/home/william/snap/arduino/current/Arduino/libraries/SdFat/src/FatLib/FatVolume.h:75:8: note:   candidate expects 1 argument, 2 provided
/home/william/snap/arduino/current/Arduino/libraries/SdFat/src/FatLib/FatVolume.h:250:8: note: candidate: bool FatVolume::chdir(const String&)
   bool chdir(const String& path) {
        ^~~~~
/home/william/snap/arduino/current/Arduino/libraries/SdFat/src/FatLib/FatVolume.h:250:8: note:   candidate expects 1 argument, 2 provided
LCDRefresh:33:43: error: no matching function for call to 'SdFat32::chdir(const char*, bool)'
     sd.chdir(CurrentDirectory.c_str(),true);
                                           ^
In file included from /home/william/snap/arduino/current/Arduino/libraries/SdFat/src/FatLib/FatLib.h:27:0,
                 from /home/william/snap/arduino/current/Arduino/libraries/SdFat/src/SdFat.h:34,
                 from /home/william/AIP/ADE/AdamNet-Drive-Emulator-master - v.90/AdamNet_Drive_Emulator/AdamNet_Drive_Emulator.ino:4:
/home/william/snap/arduino/current/Arduino/libraries/SdFat/src/FatLib/FatVolume.h:66:8: note: candidate: bool FatVolume::chdir()
   bool chdir() {
        ^~~~~
/home/william/snap/arduino/current/Arduino/libraries/SdFat/src/FatLib/FatVolume.h:66:8: note:   candidate expects 0 arguments, 2 provided
/home/william/snap/arduino/current/Arduino/libraries/SdFat/src/FatLib/FatVolume.h:75:8: note: candidate: bool FatVolume::chdir(const char*)
   bool chdir(const char *path);
        ^~~~~
/home/william/snap/arduino/current/Arduino/libraries/SdFat/src/FatLib/FatVolume.h:75:8: note:   candidate expects 1 argument, 2 provided
/home/william/snap/arduino/current/Arduino/libraries/SdFat/src/FatLib/FatVolume.h:250:8: note: candidate: bool FatVolume::chdir(const String&)
   bool chdir(const String& path) {
        ^~~~~
/home/william/snap/arduino/current/Arduino/libraries/SdFat/src/FatLib/FatVolume.h:250:8: note:   candidate expects 1 argument, 2 provided
/home/william/AIP/ADE/AdamNet-Drive-Emulator-master - v.90/AdamNet_Drive_Emulator/ProcessKeys.ino: In function 'void ProcessKeys()':
ProcessKeys:4:43: error: no matching function for call to 'SdFat32::chdir(const char*, bool)'
     sd.chdir(CurrentDirectory.c_str(),true);
                                           ^
In file included from /home/william/snap/arduino/current/Arduino/libraries/SdFat/src/FatLib/FatLib.h:27:0,
                 from /home/william/snap/arduino/current/Arduino/libraries/SdFat/src/SdFat.h:34,
                 from /home/william/AIP/ADE/AdamNet-Drive-Emulator-master - v.90/AdamNet_Drive_Emulator/AdamNet_Drive_Emulator.ino:4:
/home/william/snap/arduino/current/Arduino/libraries/SdFat/src/FatLib/FatVolume.h:66:8: note: candidate: bool FatVolume::chdir()
   bool chdir() {
        ^~~~~
/home/william/snap/arduino/current/Arduino/libraries/SdFat/src/FatLib/FatVolume.h:66:8: note:   candidate expects 0 arguments, 2 provided
/home/william/snap/arduino/current/Arduino/libraries/SdFat/src/FatLib/FatVolume.h:75:8: note: candidate: bool FatVolume::chdir(const char*)
   bool chdir(const char *path);
        ^~~~~
/home/william/snap/arduino/current/Arduino/libraries/SdFat/src/FatLib/FatVolume.h:75:8: note:   candidate expects 1 argument, 2 provided
/home/william/snap/arduino/current/Arduino/libraries/SdFat/src/FatLib/FatVolume.h:250:8: note: candidate: bool FatVolume::chdir(const String&)
   bool chdir(const String& path) {
        ^~~~~
/home/william/snap/arduino/current/Arduino/libraries/SdFat/src/FatLib/FatVolume.h:250:8: note:   candidate expects 1 argument, 2 provided
ProcessKeys:28:46: error: no matching function for call to 'SdFat32::chdir(const char*, bool)'
        sd.chdir(CurrentDirectory.c_str(),true);
                                              ^
In file included from /home/william/snap/arduino/current/Arduino/libraries/SdFat/src/FatLib/FatLib.h:27:0,
                 from /home/william/snap/arduino/current/Arduino/libraries/SdFat/src/SdFat.h:34,
                 from /home/william/AIP/ADE/AdamNet-Drive-Emulator-master - v.90/AdamNet_Drive_Emulator/AdamNet_Drive_Emulator.ino:4:
/home/william/snap/arduino/current/Arduino/libraries/SdFat/src/FatLib/FatVolume.h:66:8: note: candidate: bool FatVolume::chdir()
   bool chdir() {
        ^~~~~
/home/william/snap/arduino/current/Arduino/libraries/SdFat/src/FatLib/FatVolume.h:66:8: note:   candidate expects 0 arguments, 2 provided
/home/william/snap/arduino/current/Arduino/libraries/SdFat/src/FatLib/FatVolume.h:75:8: note: candidate: bool FatVolume::chdir(const char*)
   bool chdir(const char *path);
        ^~~~~
/home/william/snap/arduino/current/Arduino/libraries/SdFat/src/FatLib/FatVolume.h:75:8: note:   candidate expects 1 argument, 2 provided
/home/william/snap/arduino/current/Arduino/libraries/SdFat/src/FatLib/FatVolume.h:250:8: note: candidate: bool FatVolume::chdir(const String&)
   bool chdir(const String& path) {
        ^~~~~
/home/william/snap/arduino/current/Arduino/libraries/SdFat/src/FatLib/FatVolume.h:250:8: note:   candidate expects 1 argument, 2 provided
ProcessKeys:52:45: error: no matching function for call to 'SdFat32::chdir(const char*, bool)'
       sd.chdir(CurrentDirectory.c_str(),true);
                                             ^
In file included from /home/william/snap/arduino/current/Arduino/libraries/SdFat/src/FatLib/FatLib.h:27:0,
                 from /home/william/snap/arduino/current/Arduino/libraries/SdFat/src/SdFat.h:34,
                 from /home/william/AIP/ADE/AdamNet-Drive-Emulator-master - v.90/AdamNet_Drive_Emulator/AdamNet_Drive_Emulator.ino:4:
/home/william/snap/arduino/current/Arduino/libraries/SdFat/src/FatLib/FatVolume.h:66:8: note: candidate: bool FatVolume::chdir()
   bool chdir() {
        ^~~~~
/home/william/snap/arduino/current/Arduino/libraries/SdFat/src/FatLib/FatVolume.h:66:8: note:   candidate expects 0 arguments, 2 provided
/home/william/snap/arduino/current/Arduino/libraries/SdFat/src/FatLib/FatVolume.h:75:8: note: candidate: bool FatVolume::chdir(const char*)
   bool chdir(const char *path);
        ^~~~~
/home/william/snap/arduino/current/Arduino/libraries/SdFat/src/FatLib/FatVolume.h:75:8: note:   candidate expects 1 argument, 2 provided
/home/william/snap/arduino/current/Arduino/libraries/SdFat/src/FatLib/FatVolume.h:250:8: note: candidate: bool FatVolume::chdir(const String&)
   bool chdir(const String& path) {
        ^~~~~
/home/william/snap/arduino/current/Arduino/libraries/SdFat/src/FatLib/FatVolume.h:250:8: note:   candidate expects 1 argument, 2 provided
ProcessKeys:74:45: error: no matching function for call to 'SdFat32::chdir(const char*, bool)'
       sd.chdir(CurrentDirectory.c_str(),true);
                                             ^
In file included from /home/william/snap/arduino/current/Arduino/libraries/SdFat/src/FatLib/FatLib.h:27:0,
                 from /home/william/snap/arduino/current/Arduino/libraries/SdFat/src/SdFat.h:34,
                 from /home/william/AIP/ADE/AdamNet-Drive-Emulator-master - v.90/AdamNet_Drive_Emulator/AdamNet_Drive_Emulator.ino:4:
/home/william/snap/arduino/current/Arduino/libraries/SdFat/src/FatLib/FatVolume.h:66:8: note: candidate: bool FatVolume::chdir()
   bool chdir() {
        ^~~~~
/home/william/snap/arduino/current/Arduino/libraries/SdFat/src/FatLib/FatVolume.h:66:8: note:   candidate expects 0 arguments, 2 provided
/home/william/snap/arduino/current/Arduino/libraries/SdFat/src/FatLib/FatVolume.h:75:8: note: candidate: bool FatVolume::chdir(const char*)
   bool chdir(const char *path);
        ^~~~~
/home/william/snap/arduino/current/Arduino/libraries/SdFat/src/FatLib/FatVolume.h:75:8: note:   candidate expects 1 argument, 2 provided
/home/william/snap/arduino/current/Arduino/libraries/SdFat/src/FatLib/FatVolume.h:250:8: note: candidate: bool FatVolume::chdir(const String&)
   bool chdir(const String& path) {
        ^~~~~
/home/william/snap/arduino/current/Arduino/libraries/SdFat/src/FatLib/FatVolume.h:250:8: note:   candidate expects 1 argument, 2 provided
ProcessKeys:133:43: error: no matching function for call to 'SdFat32::chdir(const char*, bool)'
     sd.chdir(CurrentDirectory.c_str(),true);
                                           ^
In file included from /home/william/snap/arduino/current/Arduino/libraries/SdFat/src/FatLib/FatLib.h:27:0,
                 from /home/william/snap/arduino/current/Arduino/libraries/SdFat/src/SdFat.h:34,
                 from /home/william/AIP/ADE/AdamNet-Drive-Emulator-master - v.90/AdamNet_Drive_Emulator/AdamNet_Drive_Emulator.ino:4:
/home/william/snap/arduino/current/Arduino/libraries/SdFat/src/FatLib/FatVolume.h:66:8: note: candidate: bool FatVolume::chdir()
   bool chdir() {
        ^~~~~
/home/william/snap/arduino/current/Arduino/libraries/SdFat/src/FatLib/FatVolume.h:66:8: note:   candidate expects 0 arguments, 2 provided
/home/william/snap/arduino/current/Arduino/libraries/SdFat/src/FatLib/FatVolume.h:75:8: note: candidate: bool FatVolume::chdir(const char*)
   bool chdir(const char *path);
        ^~~~~
/home/william/snap/arduino/current/Arduino/libraries/SdFat/src/FatLib/FatVolume.h:75:8: note:   candidate expects 1 argument, 2 provided
/home/william/snap/arduino/current/Arduino/libraries/SdFat/src/FatLib/FatVolume.h:250:8: note: candidate: bool FatVolume::chdir(const String&)
   bool chdir(const String& path) {
        ^~~~~
/home/william/snap/arduino/current/Arduino/libraries/SdFat/src/FatLib/FatVolume.h:250:8: note:   candidate expects 1 argument, 2 provided
ProcessKeys:149:43: error: no matching function for call to 'SdFat32::chdir(const char*, bool)'
     sd.chdir(CurrentDirectory.c_str(),true);
                                           ^
In file included from /home/william/snap/arduino/current/Arduino/libraries/SdFat/src/FatLib/FatLib.h:27:0,
                 from /home/william/snap/arduino/current/Arduino/libraries/SdFat/src/SdFat.h:34,
                 from /home/william/AIP/ADE/AdamNet-Drive-Emulator-master - v.90/AdamNet_Drive_Emulator/AdamNet_Drive_Emulator.ino:4:
/home/william/snap/arduino/current/Arduino/libraries/SdFat/src/FatLib/FatVolume.h:66:8: note: candidate: bool FatVolume::chdir()
   bool chdir() {
        ^~~~~
/home/william/snap/arduino/current/Arduino/libraries/SdFat/src/FatLib/FatVolume.h:66:8: note:   candidate expects 0 arguments, 2 provided
/home/william/snap/arduino/current/Arduino/libraries/SdFat/src/FatLib/FatVolume.h:75:8: note: candidate: bool FatVolume::chdir(const char*)
   bool chdir(const char *path);
        ^~~~~
/home/william/snap/arduino/current/Arduino/libraries/SdFat/src/FatLib/FatVolume.h:75:8: note:   candidate expects 1 argument, 2 provided
/home/william/snap/arduino/current/Arduino/libraries/SdFat/src/FatLib/FatVolume.h:250:8: note: candidate: bool FatVolume::chdir(const String&)
   bool chdir(const String& path) {
        ^~~~~
/home/william/snap/arduino/current/Arduino/libraries/SdFat/src/FatLib/FatVolume.h:250:8: note:   candidate expects 1 argument, 2 provided
/home/william/AIP/ADE/AdamNet-Drive-Emulator-master - v.90/AdamNet_Drive_Emulator/SDCardGetDir.ino: In function 'void SDCardGetDir(int)':
SDCardGetDir:20:59: error: 'FatFile* FatVolume::vwd()' is private within this context
   while (NumberofFiles < MaxFiles && file.openNext(sd.vwd(), O_READ)) {
                                                           ^
In file included from /home/william/snap/arduino/current/Arduino/libraries/SdFat/src/FatLib/FatLib.h:27:0,
                 from /home/william/snap/arduino/current/Arduino/libraries/SdFat/src/SdFat.h:34,
                 from /home/william/AIP/ADE/AdamNet-Drive-Emulator-master - v.90/AdamNet_Drive_Emulator/AdamNet_Drive_Emulator.ino:4:
/home/william/snap/arduino/current/Arduino/libraries/SdFat/src/FatLib/FatVolume.h:336:12: note: declared private here
   FatFile* vwd() {return &m_vwd;}
            ^~~
SDCardGetDir:65:42: error: 'FatFile* FatVolume::vwd()' is private within this context
     bool lastfile = file.openNext(sd.vwd(), O_READ); // Are there any more files?
                                          ^
In file included from /home/william/snap/arduino/current/Arduino/libraries/SdFat/src/FatLib/FatLib.h:27:0,
                 from /home/william/snap/arduino/current/Arduino/libraries/SdFat/src/SdFat.h:34,
                 from /home/william/AIP/ADE/AdamNet-Drive-Emulator-master - v.90/AdamNet_Drive_Emulator/AdamNet_Drive_Emulator.ino:4:
/home/william/snap/arduino/current/Arduino/libraries/SdFat/src/FatLib/FatVolume.h:336:12: note: declared private here
   FatFile* vwd() {return &m_vwd;}
            ^~~
/home/william/AIP/ADE/AdamNet-Drive-Emulator-master - v.90/AdamNet_Drive_Emulator/SDCardSetup.ino: In function 'void SDCardSetup()':
SDCardSetup:11:41: error: no matching function for call to 'SdFat32::chdir(const char*, bool)'
   sd.chdir(CurrentDirectory.c_str(),true);
                                         ^
In file included from /home/william/snap/arduino/current/Arduino/libraries/SdFat/src/FatLib/FatLib.h:27:0,
                 from /home/william/snap/arduino/current/Arduino/libraries/SdFat/src/SdFat.h:34,
                 from /home/william/AIP/ADE/AdamNet-Drive-Emulator-master - v.90/AdamNet_Drive_Emulator/AdamNet_Drive_Emulator.ino:4:
/home/william/snap/arduino/current/Arduino/libraries/SdFat/src/FatLib/FatVolume.h:66:8: note: candidate: bool FatVolume::chdir()
   bool chdir() {
        ^~~~~
/home/william/snap/arduino/current/Arduino/libraries/SdFat/src/FatLib/FatVolume.h:66:8: note:   candidate expects 0 arguments, 2 provided
/home/william/snap/arduino/current/Arduino/libraries/SdFat/src/FatLib/FatVolume.h:75:8: note: candidate: bool FatVolume::chdir(const char*)
   bool chdir(const char *path);
        ^~~~~
/home/william/snap/arduino/current/Arduino/libraries/SdFat/src/FatLib/FatVolume.h:75:8: note:   candidate expects 1 argument, 2 provided
/home/william/snap/arduino/current/Arduino/libraries/SdFat/src/FatLib/FatVolume.h:250:8: note: candidate: bool FatVolume::chdir(const String&)
   bool chdir(const String& path) {
        ^~~~~
/home/william/snap/arduino/current/Arduino/libraries/SdFat/src/FatLib/FatVolume.h:250:8: note:   candidate expects 1 argument, 2 provided
/home/william/AIP/ADE/AdamNet-Drive-Emulator-master - v.90/AdamNet_Drive_Emulator/SDCommand.ino: In function 'void CurrentDirectoryReturn(byte)':
SDCommand:84:41: error: no matching function for call to 'SdFat32::chdir(const char*, bool)'
   sd.chdir(CurrentDirectory.c_str(),true);
                                         ^
In file included from /home/william/snap/arduino/current/Arduino/libraries/SdFat/src/FatLib/FatLib.h:27:0,
                 from /home/william/snap/arduino/current/Arduino/libraries/SdFat/src/SdFat.h:34,
                 from /home/william/AIP/ADE/AdamNet-Drive-Emulator-master - v.90/AdamNet_Drive_Emulator/AdamNet_Drive_Emulator.ino:4:
/home/william/snap/arduino/current/Arduino/libraries/SdFat/src/FatLib/FatVolume.h:66:8: note: candidate: bool FatVolume::chdir()
   bool chdir() {
        ^~~~~
/home/william/snap/arduino/current/Arduino/libraries/SdFat/src/FatLib/FatVolume.h:66:8: note:   candidate expects 0 arguments, 2 provided
/home/william/snap/arduino/current/Arduino/libraries/SdFat/src/FatLib/FatVolume.h:75:8: note: candidate: bool FatVolume::chdir(const char*)
   bool chdir(const char *path);
        ^~~~~
/home/william/snap/arduino/current/Arduino/libraries/SdFat/src/FatLib/FatVolume.h:75:8: note:   candidate expects 1 argument, 2 provided
/home/william/snap/arduino/current/Arduino/libraries/SdFat/src/FatLib/FatVolume.h:250:8: note: candidate: bool FatVolume::chdir(const String&)
   bool chdir(const String& path) {
        ^~~~~
/home/william/snap/arduino/current/Arduino/libraries/SdFat/src/FatLib/FatVolume.h:250:8: note:   candidate expects 1 argument, 2 provided
/home/william/AIP/ADE/AdamNet-Drive-Emulator-master - v.90/AdamNet_Drive_Emulator/SDCommand.ino: In function 'void MountUnmount(byte)':
SDCommand:185:41: error: no matching function for call to 'SdFat32::chdir(const char*, bool)'
   sd.chdir(CurrentDirectory.c_str(),true);
                                         ^
In file included from /home/william/snap/arduino/current/Arduino/libraries/SdFat/src/FatLib/FatLib.h:27:0,
                 from /home/william/snap/arduino/current/Arduino/libraries/SdFat/src/SdFat.h:34,
                 from /home/william/AIP/ADE/AdamNet-Drive-Emulator-master - v.90/AdamNet_Drive_Emulator/AdamNet_Drive_Emulator.ino:4:
/home/william/snap/arduino/current/Arduino/libraries/SdFat/src/FatLib/FatVolume.h:66:8: note: candidate: bool FatVolume::chdir()
   bool chdir() {
        ^~~~~
/home/william/snap/arduino/current/Arduino/libraries/SdFat/src/FatLib/FatVolume.h:66:8: note:   candidate expects 0 arguments, 2 provided
/home/william/snap/arduino/current/Arduino/libraries/SdFat/src/FatLib/FatVolume.h:75:8: note: candidate: bool FatVolume::chdir(const char*)
   bool chdir(const char *path);
        ^~~~~
/home/william/snap/arduino/current/Arduino/libraries/SdFat/src/FatLib/FatVolume.h:75:8: note:   candidate expects 1 argument, 2 provided
/home/william/snap/arduino/current/Arduino/libraries/SdFat/src/FatLib/FatVolume.h:250:8: note: candidate: bool FatVolume::chdir(const String&)
   bool chdir(const String& path) {
        ^~~~~
/home/william/snap/arduino/current/Arduino/libraries/SdFat/src/FatLib/FatVolume.h:250:8: note:   candidate expects 1 argument, 2 provided
SDCommand:233:43: error: no matching function for call to 'SdFat32::chdir(const char*, bool)'
     sd.chdir(CurrentDirectory.c_str(),true);
                                           ^
In file included from /home/william/snap/arduino/current/Arduino/libraries/SdFat/src/FatLib/FatLib.h:27:0,
                 from /home/william/snap/arduino/current/Arduino/libraries/SdFat/src/SdFat.h:34,
                 from /home/william/AIP/ADE/AdamNet-Drive-Emulator-master - v.90/AdamNet_Drive_Emulator/AdamNet_Drive_Emulator.ino:4:
/home/william/snap/arduino/current/Arduino/libraries/SdFat/src/FatLib/FatVolume.h:66:8: note: candidate: bool FatVolume::chdir()
   bool chdir() {
        ^~~~~
/home/william/snap/arduino/current/Arduino/libraries/SdFat/src/FatLib/FatVolume.h:66:8: note:   candidate expects 0 arguments, 2 provided
/home/william/snap/arduino/current/Arduino/libraries/SdFat/src/FatLib/FatVolume.h:75:8: note: candidate: bool FatVolume::chdir(const char*)
   bool chdir(const char *path);
        ^~~~~
/home/william/snap/arduino/current/Arduino/libraries/SdFat/src/FatLib/FatVolume.h:75:8: note:   candidate expects 1 argument, 2 provided
/home/william/snap/arduino/current/Arduino/libraries/SdFat/src/FatLib/FatVolume.h:250:8: note: candidate: bool FatVolume::chdir(const String&)
   bool chdir(const String& path) {
        ^~~~~
/home/william/snap/arduino/current/Arduino/libraries/SdFat/src/FatLib/FatVolume.h:250:8: note:   candidate expects 1 argument, 2 provided
SDCommand:241:43: error: no matching function for call to 'SdFat32::chdir(const char*, bool)'
     sd.chdir(CurrentDirectory.c_str(),true);
                                           ^
In file included from /home/william/snap/arduino/current/Arduino/libraries/SdFat/src/FatLib/FatLib.h:27:0,
                 from /home/william/snap/arduino/current/Arduino/libraries/SdFat/src/SdFat.h:34,
                 from
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
