Kalidomra/AdamNet-Drive-Emulator/AdamNet_Drive_Emulator/ResetInterrupt.ino

void ResetInterrupt(){                                             // Reset from the Adam
  unsigned long resettimeout = 0;
  if (!DisableNextReset){
    if ((millis() - TimetoByte > 200) && (ResetFlag == 0)){
      TimetoByte = millis();               // Set the time that the reset came in
      while (((PIND & _BV(PD1)) == 0) && (resettimeout <= 10000)){ // Wait for PD1 to go HIGH, This gets out of the reset.
        resettimeout++;
      }
      ResetFlag = 1;                       // Set the reset flag
    }
  }
  else{
    Serial.println(F("Skipping this reset"));
    Serial.println(F("Compatible Block Mode Enabled"));
    CompMode = true;                       // Turn on Compatible Block Mode
    DisableNextReset=false;
  }

  EIFR = bit (INTF1);                      // Clear flag for any interrupts on INT1 that were triggered while in the ISR
}
