Kalidomra/AdamNet-Drive-Emulator/AdamNet_Drive_Emulator/StatusSetup.ino

void StatusSetup(byte Statusin,byte device){                       // Setup the Status Array with the Correct Device and CheckSum
  byte currentbyte = 0x00;
  byte checksum = 0x00;
  Status[device-4][0] = 0x80 + device;
  Status[device-4][1] = 0x00;              // Maximum Msg Length - Low Byte
  Status[device-4][2] = 0x04;              // Maximum Msg Length - High Byte
  Status[device-4][3] = 0x01;              // Upper = reserved, Lower is transmit code (1 for block mode, 0 for Character mode)
  Status[device-4][4] = Statusin;          // Status Block( 0x40 = Ok, 0x41 = Bad Block, 0x42 = No Block, 0x43 = No disk, 0x44 = No Drive)
  for (int i=1; i<=4;i++){
    currentbyte = Status[device-4][i];
    checksum ^= currentbyte;
  }
  Status[device-4][5] = checksum;
}
